MichaelVaryuschenko/StratosphericMission/Зонд/Постер/ProjectPhotoPlaceholder.jpg

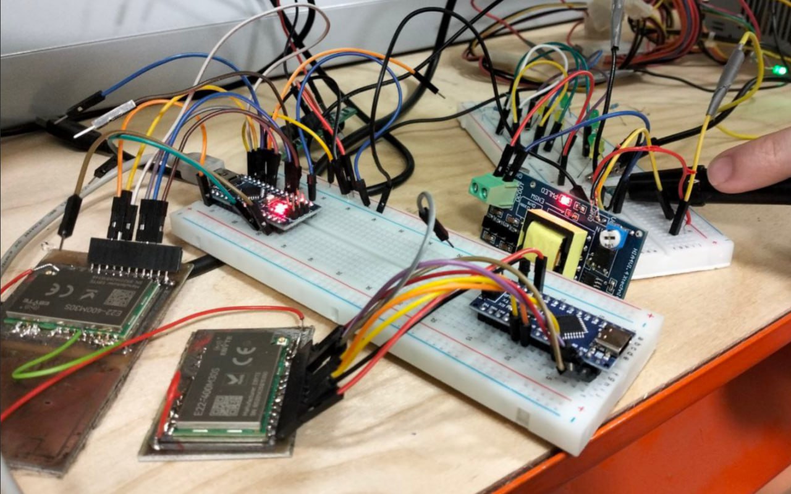
Зонд/Постер/ProjectPhotoPlaceholder.jpg
