MichaelVaryuschenko/StratosphericMission/README.md

# StratosphericMission
Материалы по проекту "Стратосферный зонд для регистрации космических лучей".
