MichaelVaryuschenko/StratosphericMission/Зонд/Компоненты схемы преобразователя.odt

Транзистор IRF-840

Катушка индуктивности 330 мкГн

Конденсатор 4.7 мкФ

Диод HER-108

Резистор в ШИМ-цепи -- ???

Нагрузочный резистор -- ???
