MichaelVaryuschenko/StratosphericMission/Зонд/платы на печать.odt

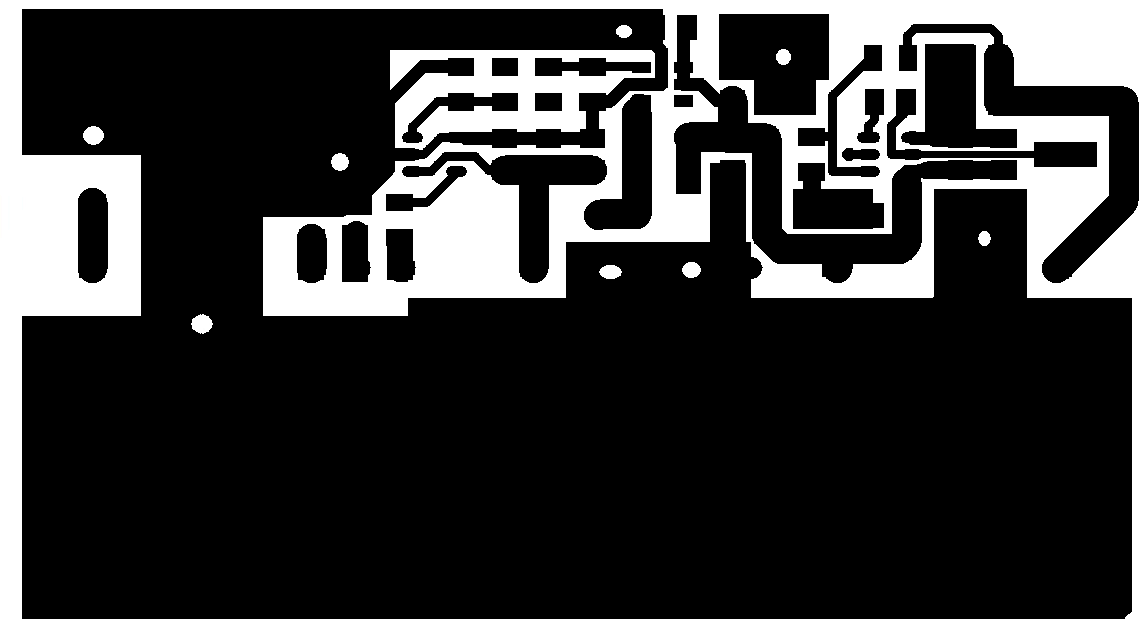
[picture p2: figure]
