MichaelVaryuschenko/StratosphericMission/Зонд/Постер/Постер черновик 3.pdf

### Варющенко Михаил Константинович Ахметшина Юлия Эдуардовна

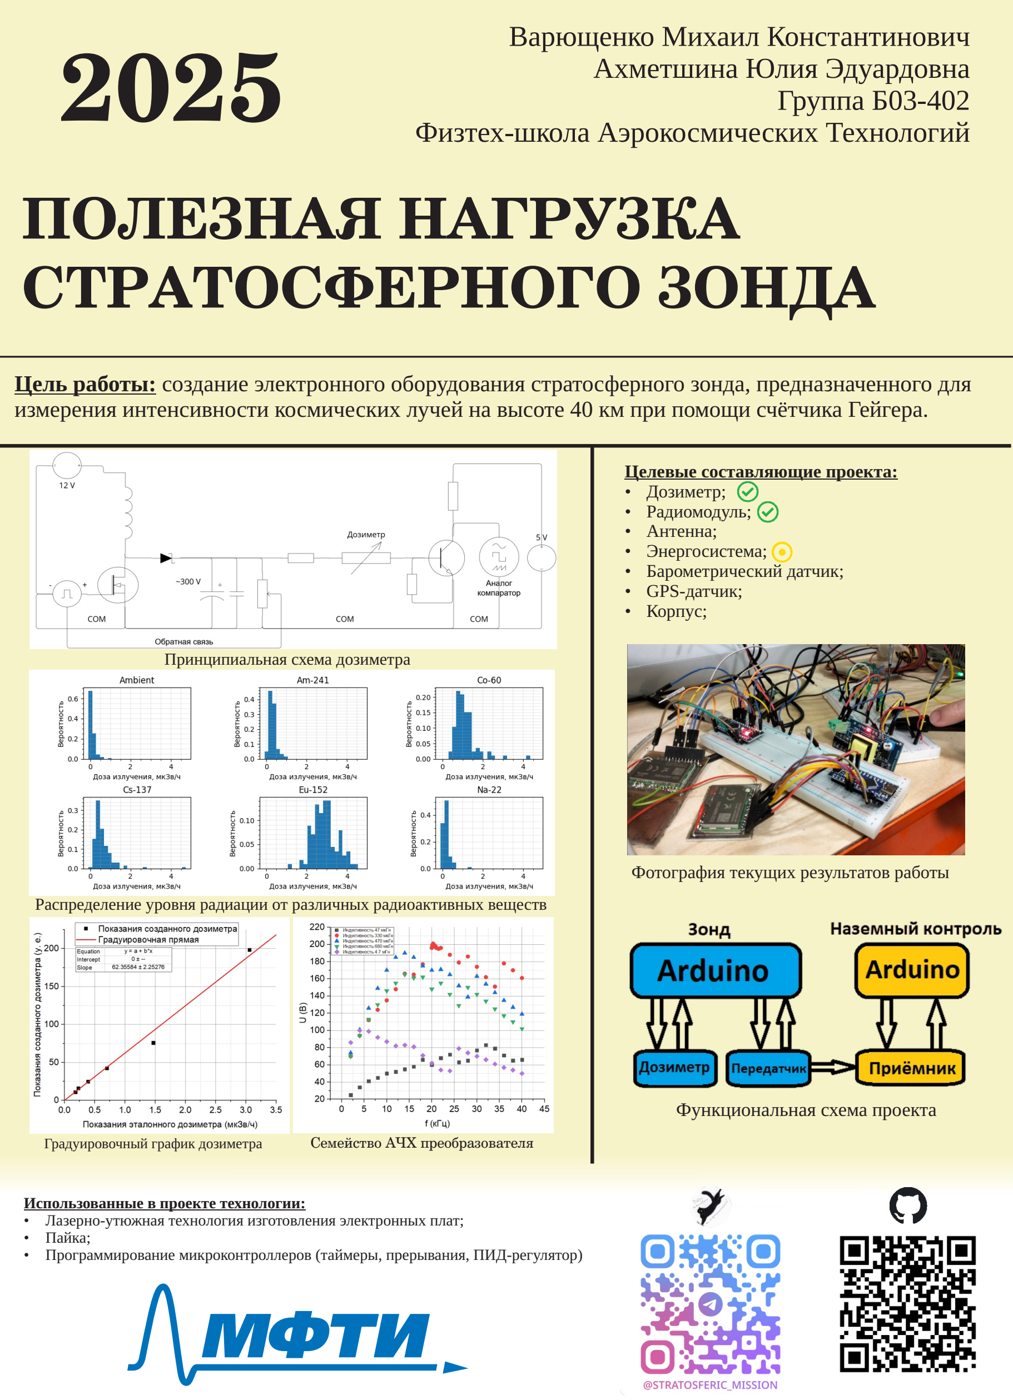
[picture p13: page 1]

### Группа Б03-402 2025

### Физтех-школа Аэрокосмических Технологий

# ПОЛЕЗНАЯ НАГРУЗКА СТРАТОСФЕРНОГО ЗОНДА

Фотография текущих результатов работы

Целевые составляющие проекта:
- Дозиметр;
- Радиомодуль;
- Антенна;
- Энергосистема;
- Барометрический датчик;
- GPS-датчик;
- Корпус;

Принципиальная схема дозиметра

Градуировочный график дозиметра | Семейство АЧХ преобразователя

Функциональная схема проекта

Цель работы: создание электронного оборудования стратосферного зонда, предназначенного для измерения интенсивности космических лучей на высоте 40 км при помощи счётчика Гейгера.

Распределение уровня радиации от различных радиоактивных веществ

Использованные в проекте технологии:
- Лазерно-утюжная технология изготовления электронных плат;
- Пайка;
- Программирование микроконтроллеров (таймеры, прерывания, ПИД-регулятор)
