MichaelVaryuschenko/StratosphericMission/Зонд/Постер/Постер черновик.pdf

## Варющенко Михаил Ахметшина Юлия

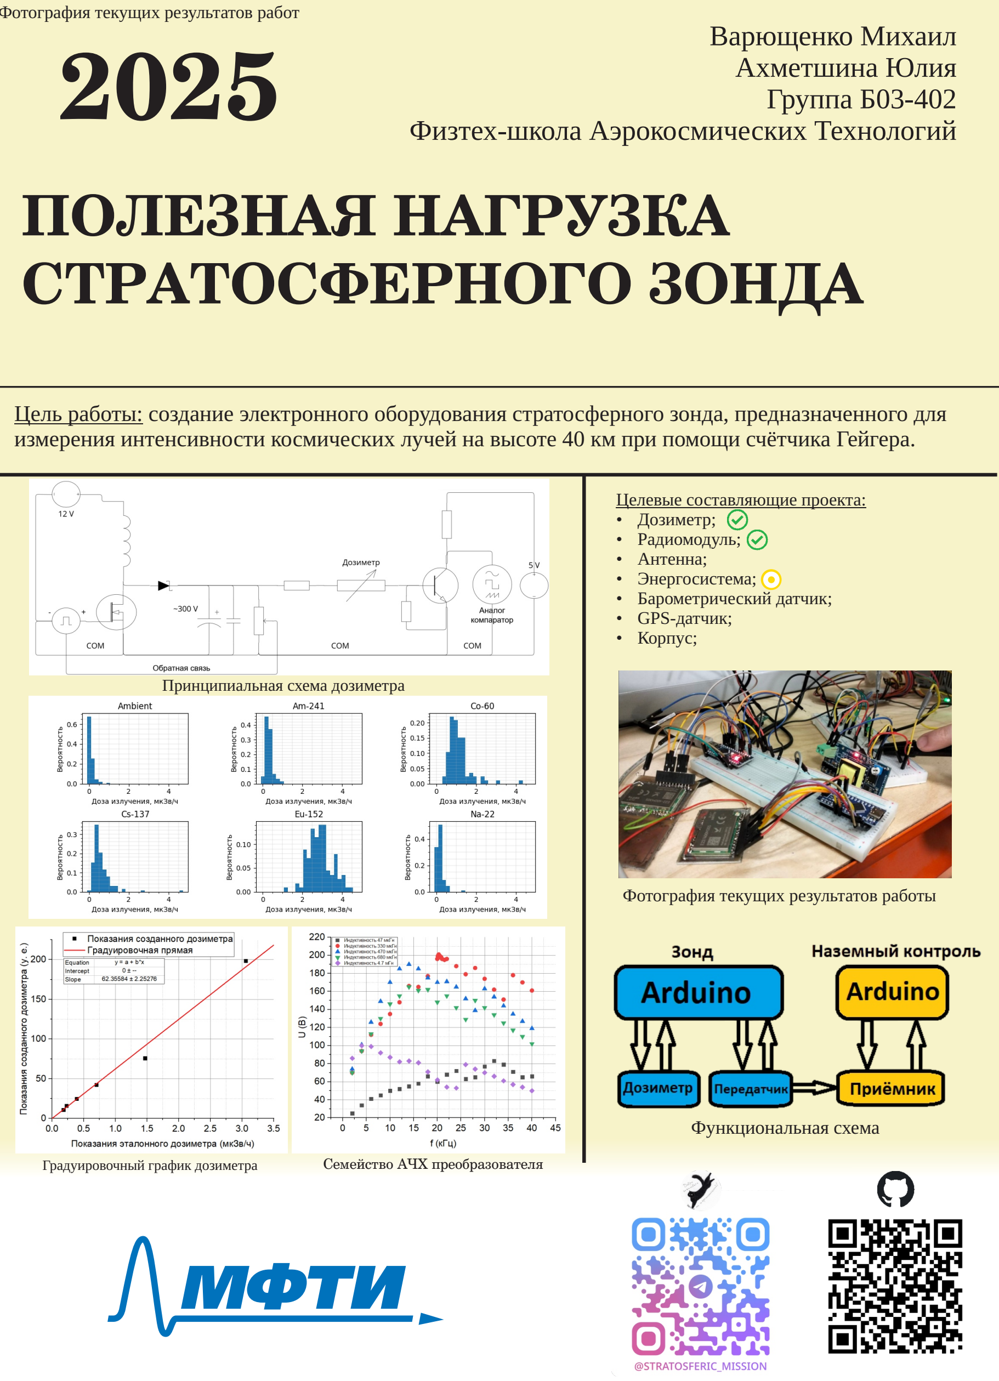
[picture p14: page 1]

## Группа Б03-402 2025

## Физтех-школа Аэрокосмических Технологий

# ПОЛЕЗНАЯ НАГРУЗКА СТРАТОСФЕРНОГО ЗОНДА

Фотография текущих результатов работ

Фотография текущих результатов работы

Целевые составляющие проекта:
- Дозиметр;
- Радиомодуль;
- Антенна;
- Энергосистема;
- Барометрический датчик;
- GPS-датчик;
- Корпус;

Принципиальная схема дозиметра

Градуировочный график дозиметра | Семейство АЧХ преобразователя

Функциональная схема

Цель работы: создание электронного оборудования стратосферного зонда, предназначенного для измерения интенсивности космических лучей на высоте 40 км при помощи счётчика Гейгера.
