MichaelVaryuschenko/StratosphericMission/Зонд/Градуировка дозиметра/градуировка.jpg

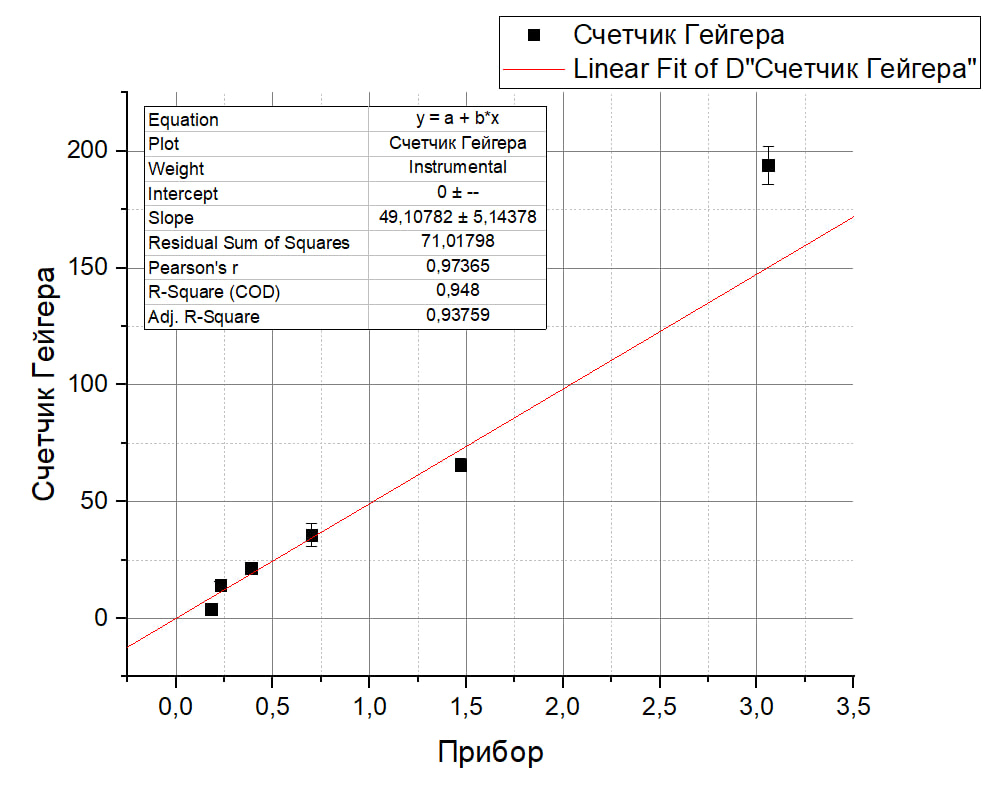
Зонд/Градуировка дозиметра/градуировка.jpg
