MichaelVaryuschenko/StratosphericMission/Зонд/Плата_2_ВИ.jpg

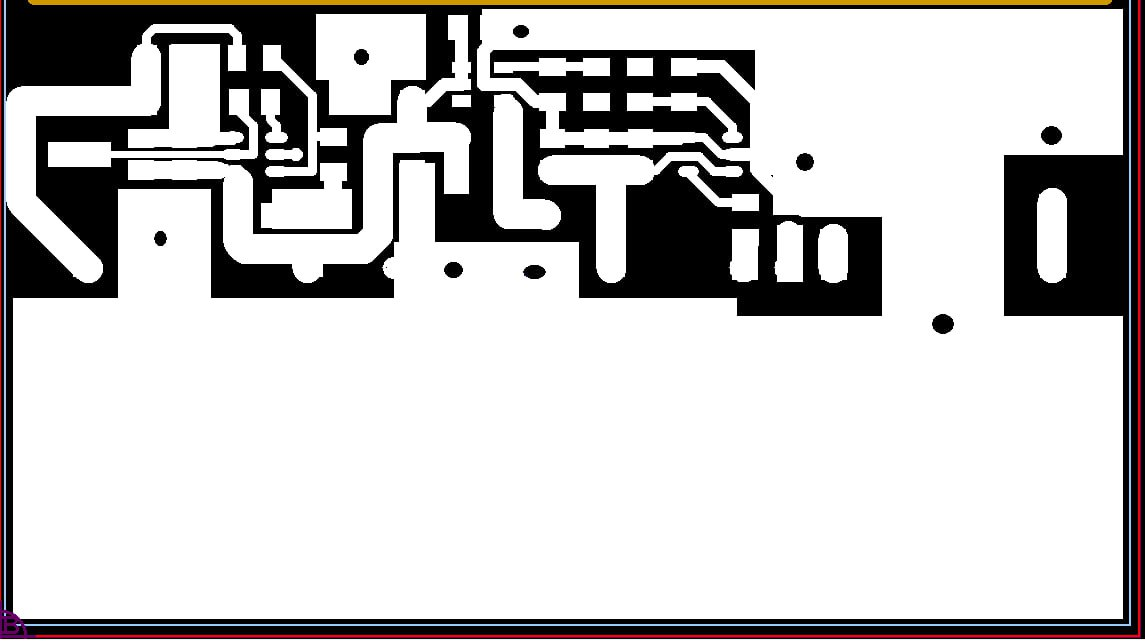
Зонд/Плата_2_ВИ.jpg
