MichaelVaryuschenko/StratosphericMission/Зонд/Плата_2_ВИ_на_печать.jpg

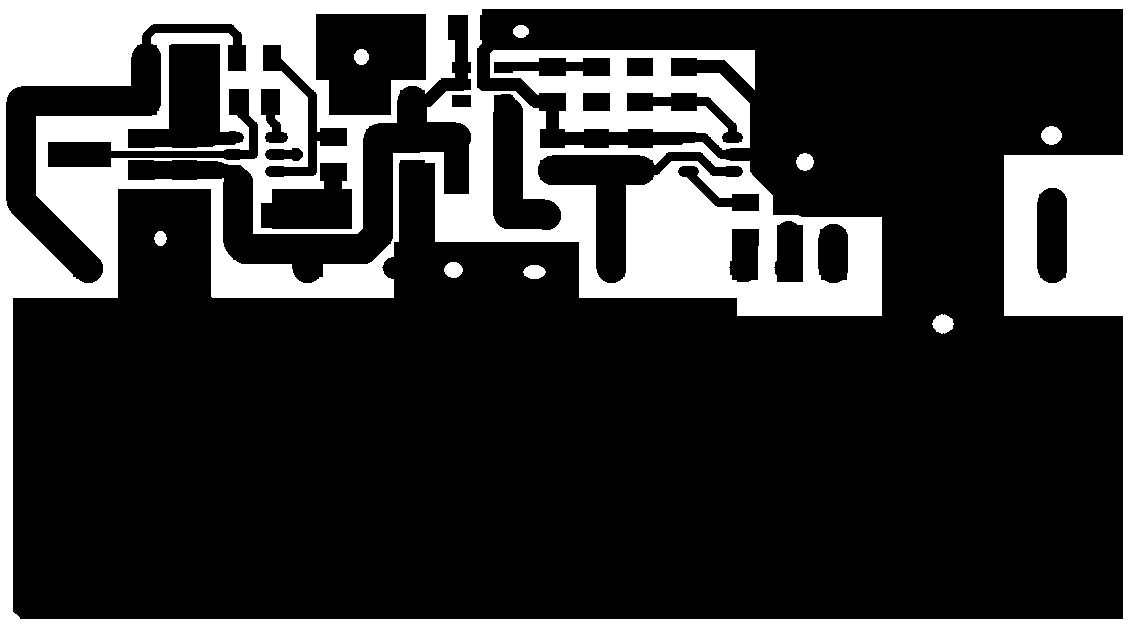
Зонд/Плата_2_ВИ_на_печать.jpg
