MichaelVaryuschenko/StratosphericMission/Зонд/Постер/ChannelQR.png

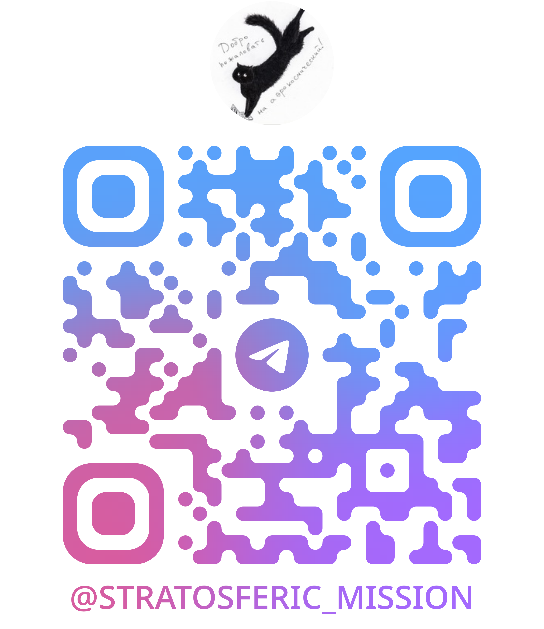
Зонд/Постер/ChannelQR.png
