MichaelVaryuschenko/StratosphericMission/Зонд/Постер/Dosimeter.png

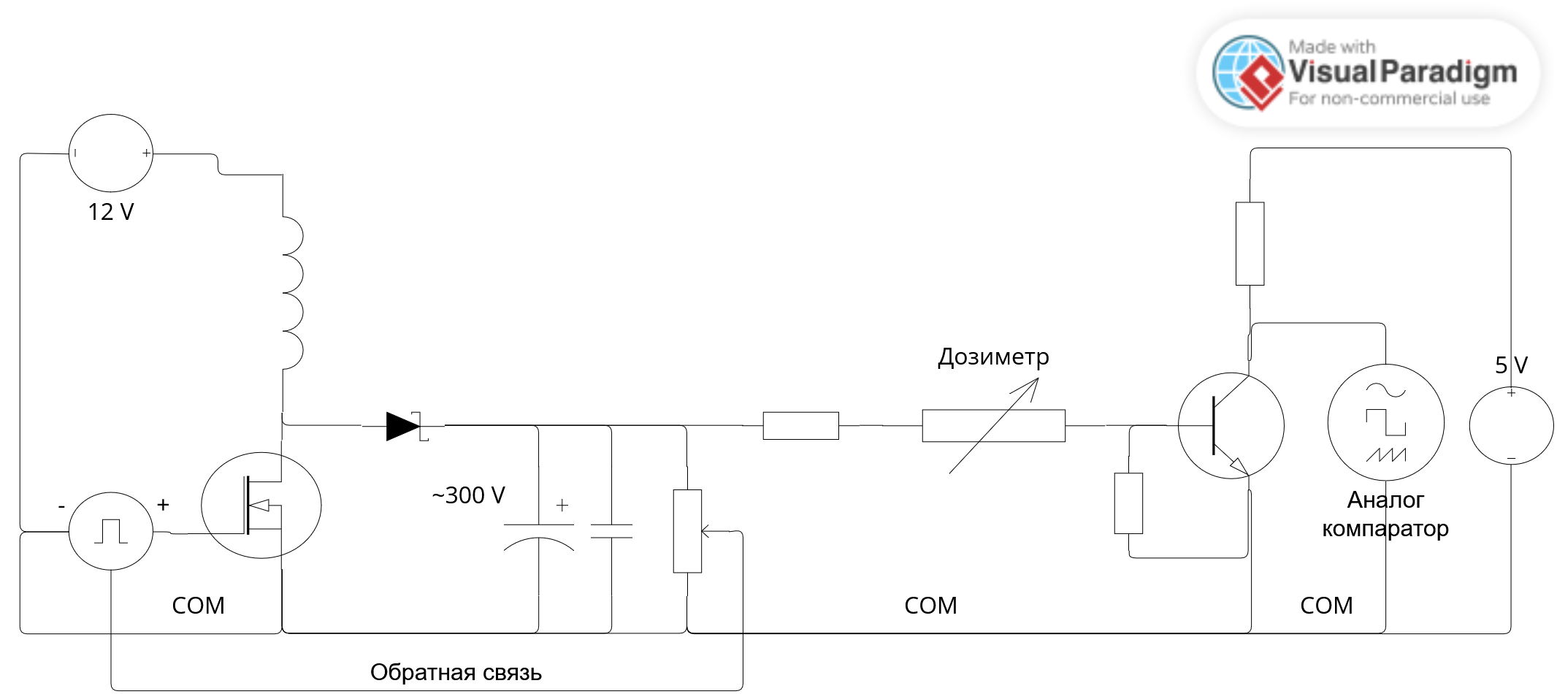
Зонд/Постер/Dosimeter.png
