MichaelVaryuschenko/StratosphericMission/Зонд/Постер/FuncScheme-Transparent.png

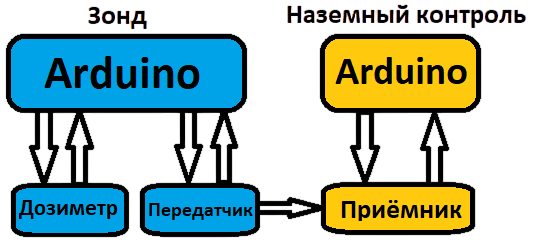
Зонд/Постер/FuncScheme-Transparent.png
