MichaelVaryuschenko/StratosphericMission/Зонд/Постер/GitHubQR.png

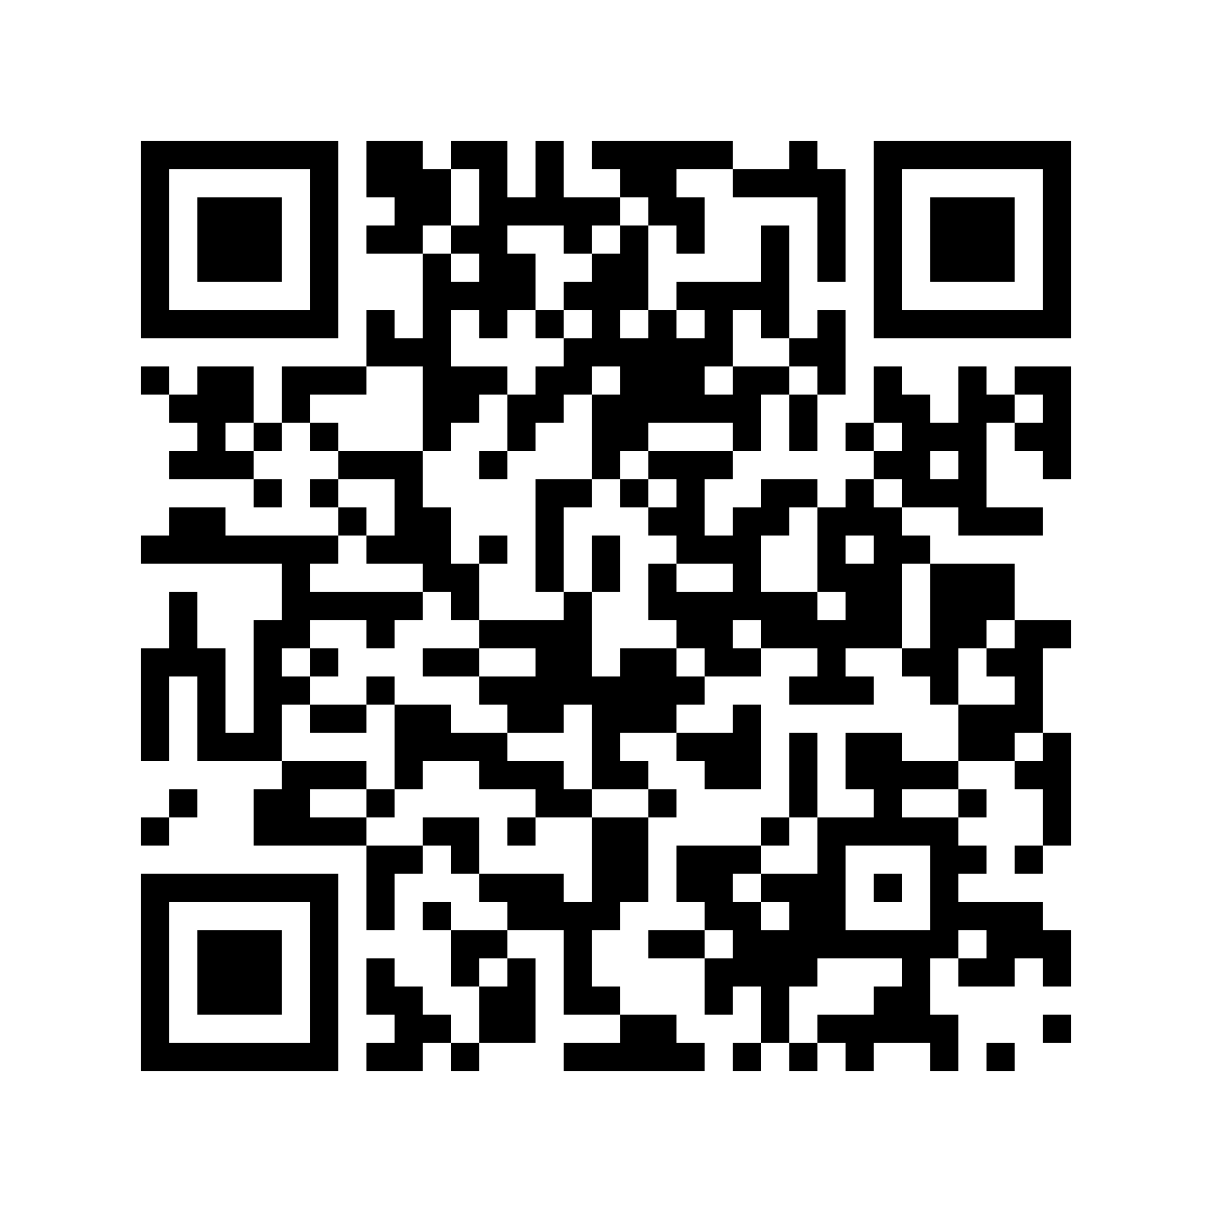
Зонд/Постер/GitHubQR.png
