MichaelVaryuschenko/StratosphericMission/Зонд/Постер/Graduat.PNG

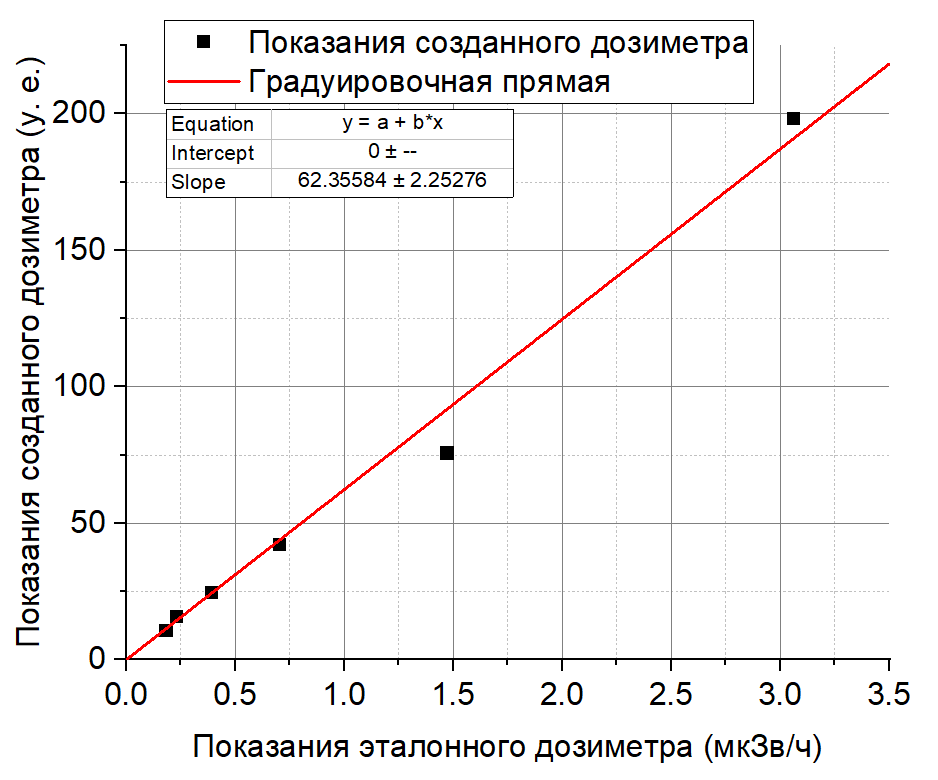
Зонд/Постер/Graduat.PNG
