MichaelVaryuschenko/StratosphericMission/Зонд/Постер/RadiationDistributions.png

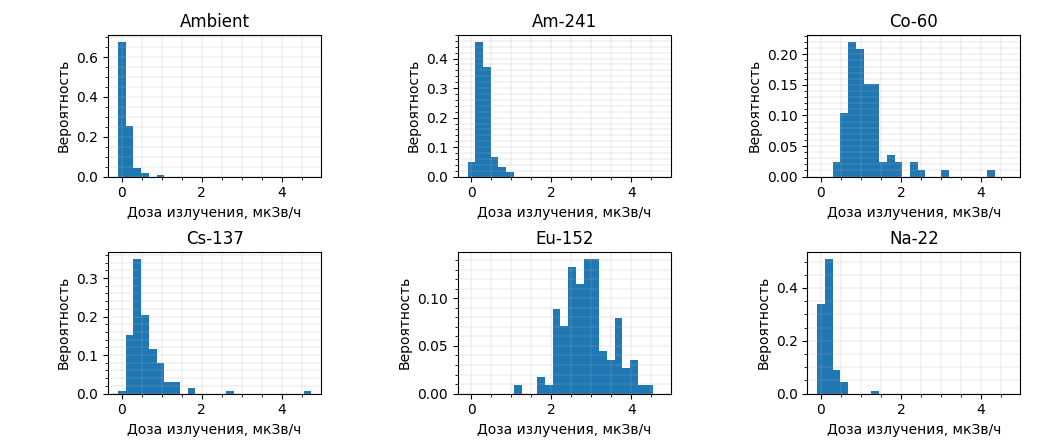
Зонд/Постер/RadiationDistributions.png
