MichaelVaryuschenko/StratosphericMission/Зонд/E22-Nano pinout.xls

Arduino Nano | E22-400M30S
GND:14 | GND:1
D7:25 | RXEN:6
D2:20 | TXEN:7
D3:21 | DIO1:13
D4:22 | BUSY:14
D8:26 | NRST:15
D12:30 | MISO:16
D11:29 | MOSI:17
D13:1 | SCK:18
D10:28 | NSS:19
