MichaelVaryuschenko/StratosphericMission/Зонд/Test Arduino scetches/bmp280_SPI/Readme.txt

1. Скетч -> Подключить библиотеку -> Подключить ZIP. ... (подключаем зип-архив из папки bmp280_SPI)
2. Скетч -> Подключить библиотеку -> Управление библиотеками: Adafruit Unified Sensor. Скачать.
Можно пользоваться
