MichaelVaryuschenko/StratosphericMission/Зонд/Постер/ConverterCharacteristics.PNG

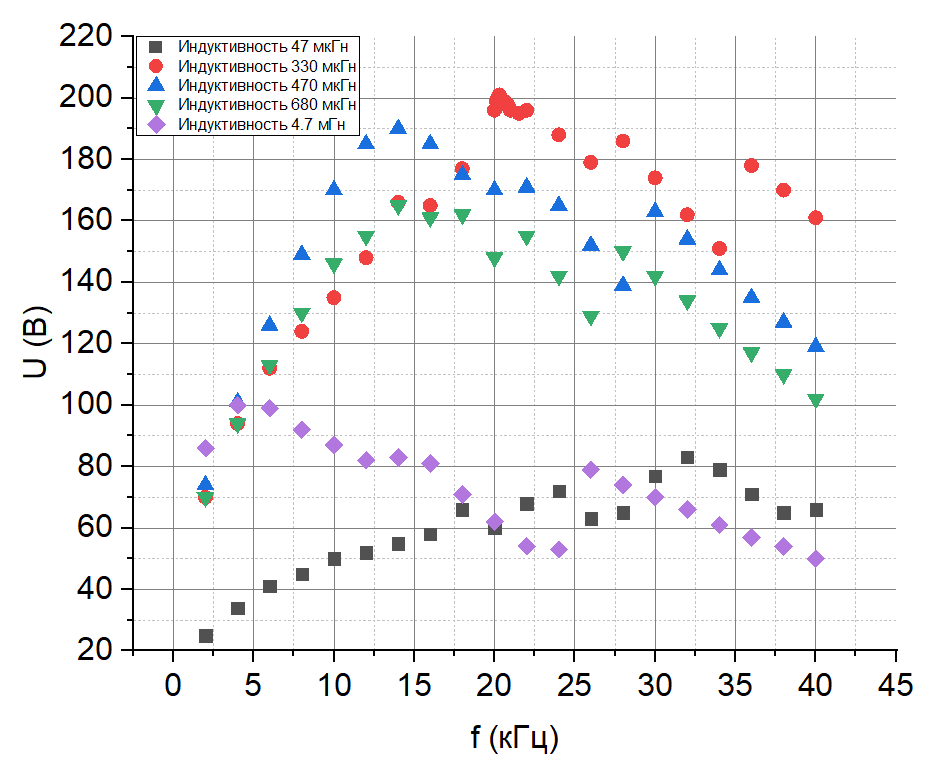
Зонд/Постер/ConverterCharacteristics.PNG
