MichaelVaryuschenko/StratosphericMission/(commit log)

2025-10-27 Создание репозитория
    [E22-Nano pinout.xls, Хар-ка преобразователя.ods]
2025-11-13 Add files via upload
    В файле данные, по которым можно провести градуировку дозиметра: В одном столбце показано установившееся значение в мкЗв, выдаваемое дозиметром Radex вблизи радиоактивных источников и в их отсутствие, далее - в строках показания самодельного дозиметра при тех же условиях. График построен в осях: среднее число импульсов в сек через дозиметр в зависимости от показаний при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
    [таблица с числом импульсов.ods]
2025-12-01 Create Датчик давления
2025-12-01 Подключение датчика давления hw211 e/p 280
